WBCanSat/CanSatCode/FDR/FDR.pdf

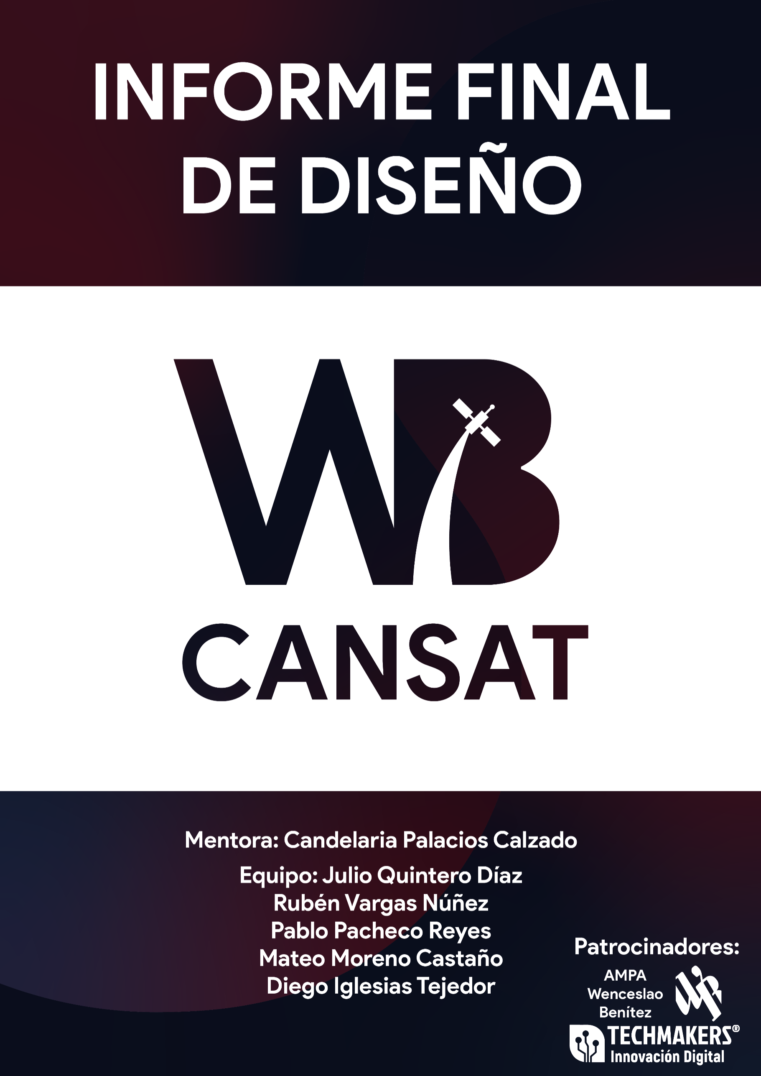
[picture p21: page 1]

## ÍNDICE

1.2. El equipo, el reparto de tareas y la organización del trabajo....... 3
3. DISEÑO MECÁNICO DEL CANSAT Y DE LA ESTACIÓN DE TIERRA...... 5

### 5. PROGRAMACIÓN. LENGUAJE DE PROGRAMACIÓN Y DIAGRAMA DE

FLUJO DEL PROGRAMA. BREVE EXPLICACIÓN DEL FUNCIONAMIENTO ... 10

7. SISTEMAS DE ATERRIZAJE. PARACAÍDAS U OTROS SISTEMAS.

### 10. PROYECTO CIENTÍFICO. DESCRIPCIÓN DEL PLAN DE ACTUACIÓN

DEL DÍA DEL LANZAMIENTO. PLANTEAR SOLUCIONES ANTE POSIBLES

11. ESTADO DE LA DIFUSIÓN Y DIVULGACIÓN DEL PROYECTO. FOTOS,

### 1. INTRODUCCIÓN/ ANTECEDENTES

### 1.1. Introducción

Este año, cursando 1º de bachillerato, nos embarcamos en el concurso CanSat, un proyecto a gran escala con el fin de desafiar nuestro conocimiento.

### 1.2. El equipo, el reparto de tareas y la organización del trabajo

- El equipo se conforma de cinco miembros: Julio Quintero, Pablo Pacheco, Mateo Moreno, Rubén Vargas y Diego Iglesias.
- Las tareas fueron asignadas teniendo en cuenta los conocimientos y capacidades de cada integrante, para lograr la máxima eficiencia.
- Debido a la pandemia hemos decidido organizarnos para que pudiéramos realizar todo desde nuestras casas:

❏ Hemos creado un grupo de Telegram y un sevidor de Discord para mantener contacto con nuestra mentora y realizar reuniones.

❏ Para la elaboración del informe CDR y FDR, trabajamos en Google Docs.

❏ Por último, hemos creado un WBS para organizar los trabajos que tenía que desarrollar cada uno

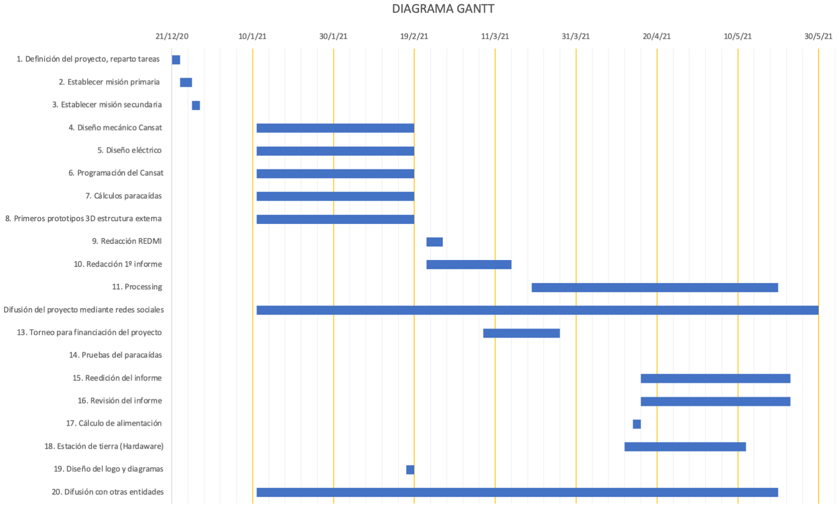
[picture p22: figure]

### 2. PROYECTO CANSAT

CanSat es un concurso diseñado para simular algunos de los objetivos principales de un satélite real, pero teniendo en cuenta una limitación importante: el tamaño de una lata. Es decir, hay que incluir los sensores, la alimentación y la comunicación necesaria en el espacio reducido de una lata.

### 2.1. Misiones

A continuación, se desarrollará las dos misiones principales en las que se basa el proyecto:

### 2.1.1. Misión primaria

Su objetivo es medir dos parámetros durante el descenso del CanSat, que serán la presión y la temperatura. La información captada se transmite a la estación de tierra a través de telemetría durante el transcurso de la bajada.

Hemos elegido la placa Arduino Nano como principal componente de hardware, como lenguaje de programación Arduino (C/C++) y como entorno de desarrollo Visual Studio Code.

### 2.1.2. Misión secundaria

En un principio, la idea era examinar la vegetación de la zona desde el satélite. Para ello, mediríamos la eficiencia de la fotosíntesis de las plantas, basándonos en la fluorescencia de la clorofila que éstas emiten, con ello podríamos determinar la salud de las zonas verdes, bosques, reservas naturales... Sin embargo, tras una exhaustiva investigación sobre este estudio, rechazamos la idea debido a la complejidad para encontrar sensores que se adaptaran al presupuesto máximo impuesto en las bases del concurso.

Así pues, aunque optamos por utilizar sensores MQ, el objetivo seguiría estando centrado en el medioambiente: identificar el aumento de emisiones de gases de efecto invernadero en vertederos, industrias, ciudades concurridas y otro tipo de zonas peligrosas que perjudiquen el medio ambiente y que estén por encima de las adoptadas en el Acuerdo de París. Todo ello para poder reducirlas cuando sean detectadas. Como se graficarán y representarán los datos se ampliará en el epígrafe 6.

Esta idea puede extrapolarse de distintas formas. Primeramente, aunque usemos sensores MQ que tienen baja resolución, se podrían utilizar espectrómetros de imagen de alta resolución (high-resolution imaging spectrometer) para poder observar estas variaciones desde la órbita terrestre. Un ejemplo a esto sería el satélite Iris de GHGSat, que puede observar altas concentraciones de metano.

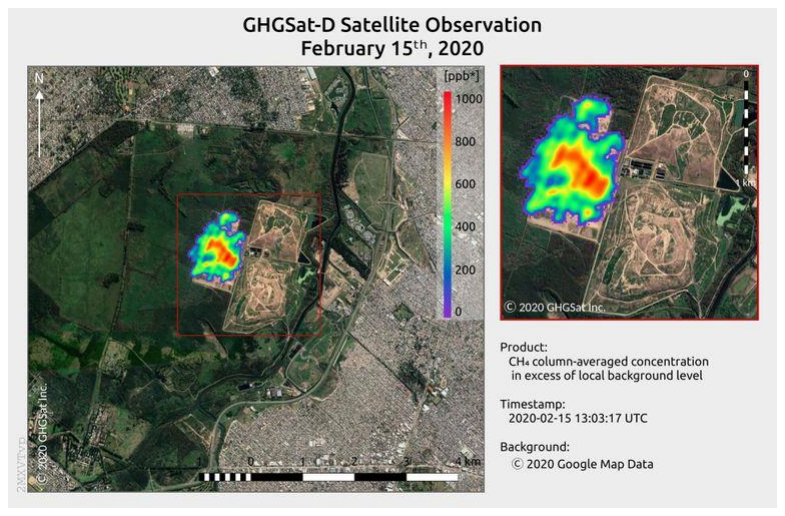
[picture p23: figure]
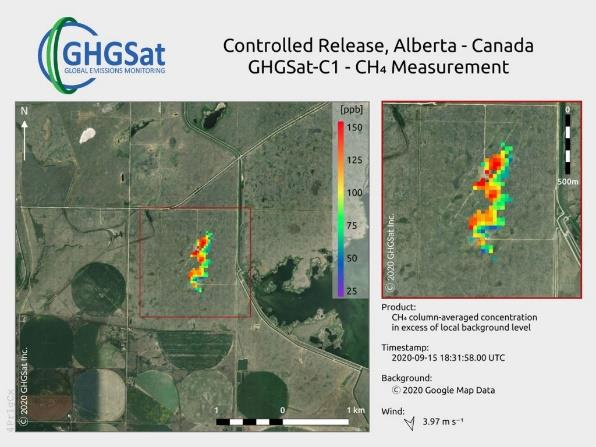
[picture p24: figure]

(Anon., 2021) | (Bishton, 2020)

A su vez, se pueden utilizar sensores que midan la concentración de la fluorescencia de la clorofila, en vez de aquellos que miden gases de efecto invernadero. Esta extrapolación estaría conectada con nuestra primera idea.

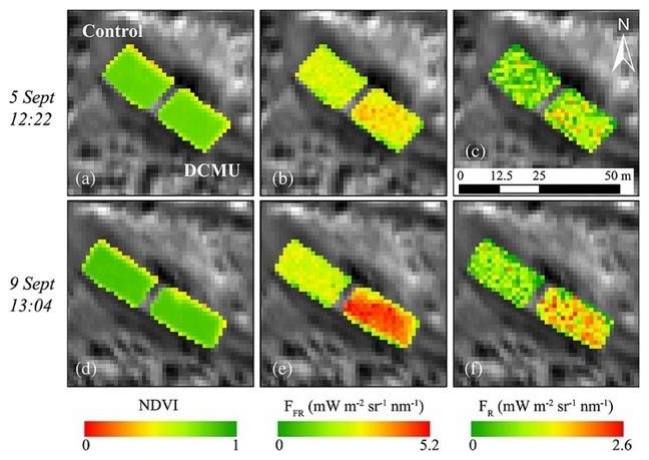
[picture p25: figure]

(Anon., 2015)

Por último, suponiendo que el Cansat fuese un satélite espacial, se podría utilizar para investigar las atmósferas de otros planetas y comprobar la presencia de gases que propicien la vida, tanto extraterrestre como para posibles colonias humanas.

### 2.2. Resultados esperados

Con nuestra misión esperamos obtener durante el descenso los valores de concentración de CH4 (metano) y CO2 (dióxido de carbono) cada segundo enviando los datos por telemetría a la estación de tierra. Con los datos obtenidos seremos capaces de determinar los niveles de concentración para cada uno de ellos y comprobar que valores no cumplen con los límites establecidos. Además de observar la relación que pueden tener estos parámetros con la temperatura de la zona específica.

### 3. DISEÑO MECÁNICO DEL CANSAT Y DE LA ESTACIÓN DE

TIERRA.

Al empezar a diseñar el CanSat nos dimos cuenta que tenía que tener unas medidas específicas, nuestro satélite no podía superar una altura de 115mm y 65mm de diámetro. Esto nos dio un poco de dificultad, pero con trabajo pudimos encajar todo. Aprovechamos que nuestro instituto disponía de una impresora 3D, para construir el diseño mediante diversas aplicaciones, hasta acabar con el resultado más profesional posible. Hemos decidido que nuestra estructura interna y externa están separadas, debido a que a la hora de manipularlos y trabajar con ellos va ser mucho más fácil que trabajar en un recipiente hermético de paredes.

### 3.1. Estructura Externa

Para la estructura externa, nos apoyamos principalmente en dos programas: Tinkercard y Freecad. En el primero, se esbozó el prototipo y en el segundo se utilizó para dar un acabado más profesional a la maqueta final.

Al principio pensamos en un prototipo que encajase mediante deslizamiento hacia arriba, pero lo descartamos, ya que podía ocasionar problemas con los cables Después, ideamos uno con bisagras, pero finalmente se descartó debido a la dificultad para incluir las bisagras en la carcasa de plástico.
Los dos últimos fueron los mejores, debido a que iban fijados con tornillos y era mucho más fácil a la hora de manipularlos. Tardamos unas 5 semanas, puesto que realizamos pruebas para ver su resistencia.
Tras ellas, decidimos poner las paredes laterales de 2 mm y las inferiores de 3mm en las bases, para lograr la resistencia adecuada para que no se rompiese.

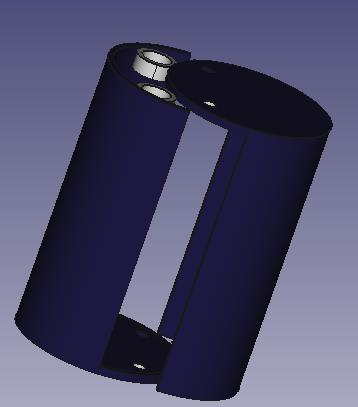
[picture p26: figure]
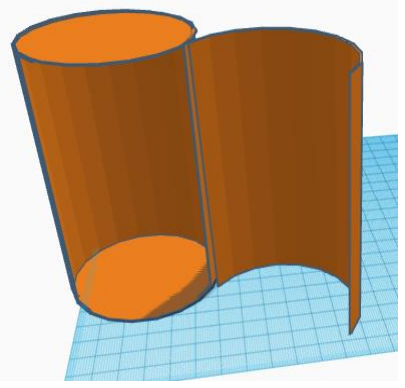
[picture p27: figure]
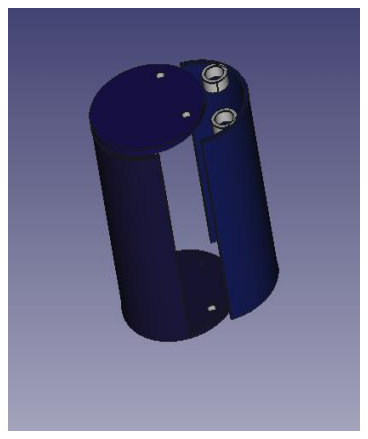
[picture p28: figure]

Para la impresión en 3D hemos probado con dos tipos de filamento, PLA y ABS, de 1.75 mm con el software CURA. Hemos tenido dificultades para imprimir ya que la impresora 3D del centro no soportaba bien la alta temperatura del ABS. Sin embargo, hemos conseguido imprimir un prototipo en PLA gracias a Manuel y su impresora.

Prototipo 1(TINKERCAD) | Prototipo 2(freecad) | Prototipo 3(freecad)

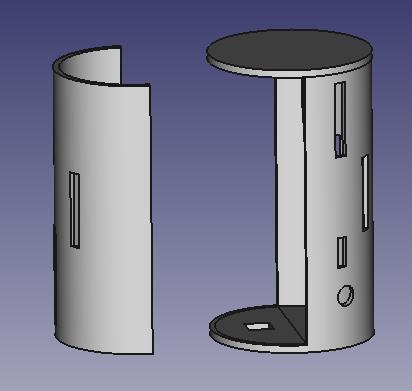
[picture p29: figure]

Cuenta | con | cuatro

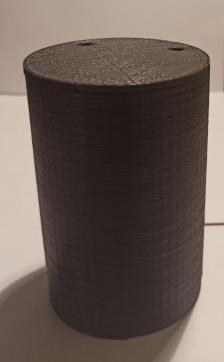
[picture p30: figure]
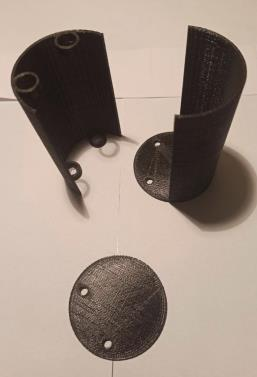
[picture p31: figure]

orificios de ventilación para que los sensores tomen la muestra de gases de la atmosfera. En ellos, también se insertan el led, el interruptor y sensor gps.

### 3.2. Estructura interna

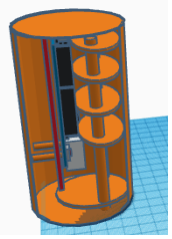
[picture p32: figure]

La condición principal es que fuera fácil de manipular y de este modo, si existiese algún problema con un sensor no sería necesario desconectar todos los cables.

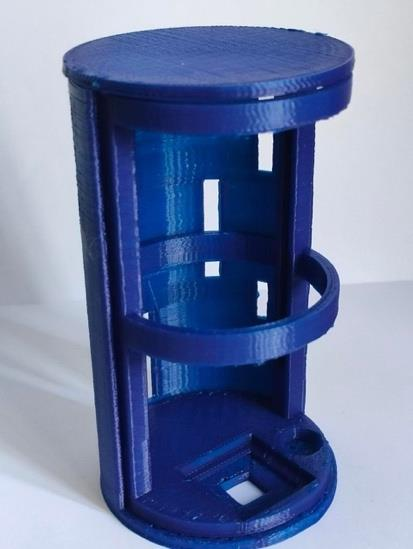
[picture p33: figure]
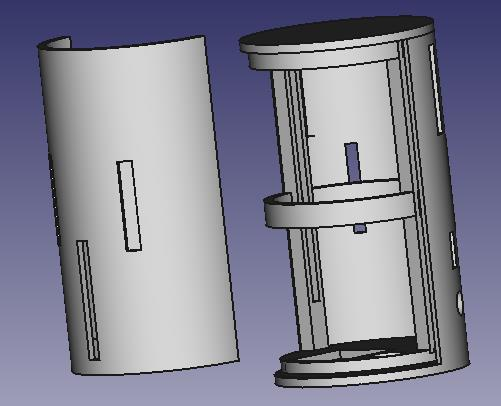
[picture p34: figure]

Al pasarlo al freecad retocamos un poco la idea del tinkercad, debido a que lo queríamos hacer una estructura un poco mas profesional y mas fácil de manipular.

### 3.3. Componentes

Prototipo 3 impreso

Prototipo final

Estructura interna final

Nombre | Masa | Dimensiones | Voltaje | Amperaje | Sensibilidad
BMP280 | 1.07g | 1.9x1cm | 4V | 20mA | Presión: +-1Hpa Temperatura: +-0.5ºC
MQ-4 | 6.8g | 3.2x2cm | 3.5V-5V | 150mA
GPS-NEO6 | 16.8g | 3.5x2.5 cm | 2.7V-3.6V | 37mA | +-2.5m en velocidad 0.1m/s
Zumbador | 1.2g | 3cm r | 3.5V-5.5V | 25mA | +-500Hz
MQ-135 | 6.8g | 3.2x2cm | 4V | 150mA

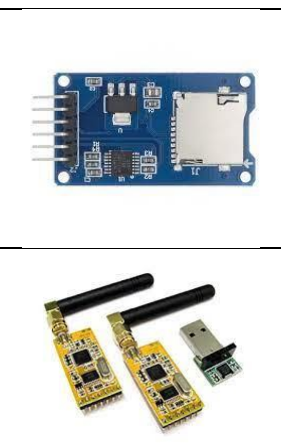
[picture p35: figure]

Lector Sd | 4.38g | 4.2x2.3cm | 3.3V-5V | 15 mA | X
Radio apc 220 | 11.4g | 3.7x1.8cm | 3.5V-5V | 30mA | X
Arduino nano | 5.89g | 4.3x1,7cm | 5V | 20mA | X
Masa componentes | 54,34 g
Masa componentes + pila | 101,27 g
Masa total (componentes, carcasa, paracaídas…) | 173,45 g

### 4. DISEÑO ELÉCTRICO

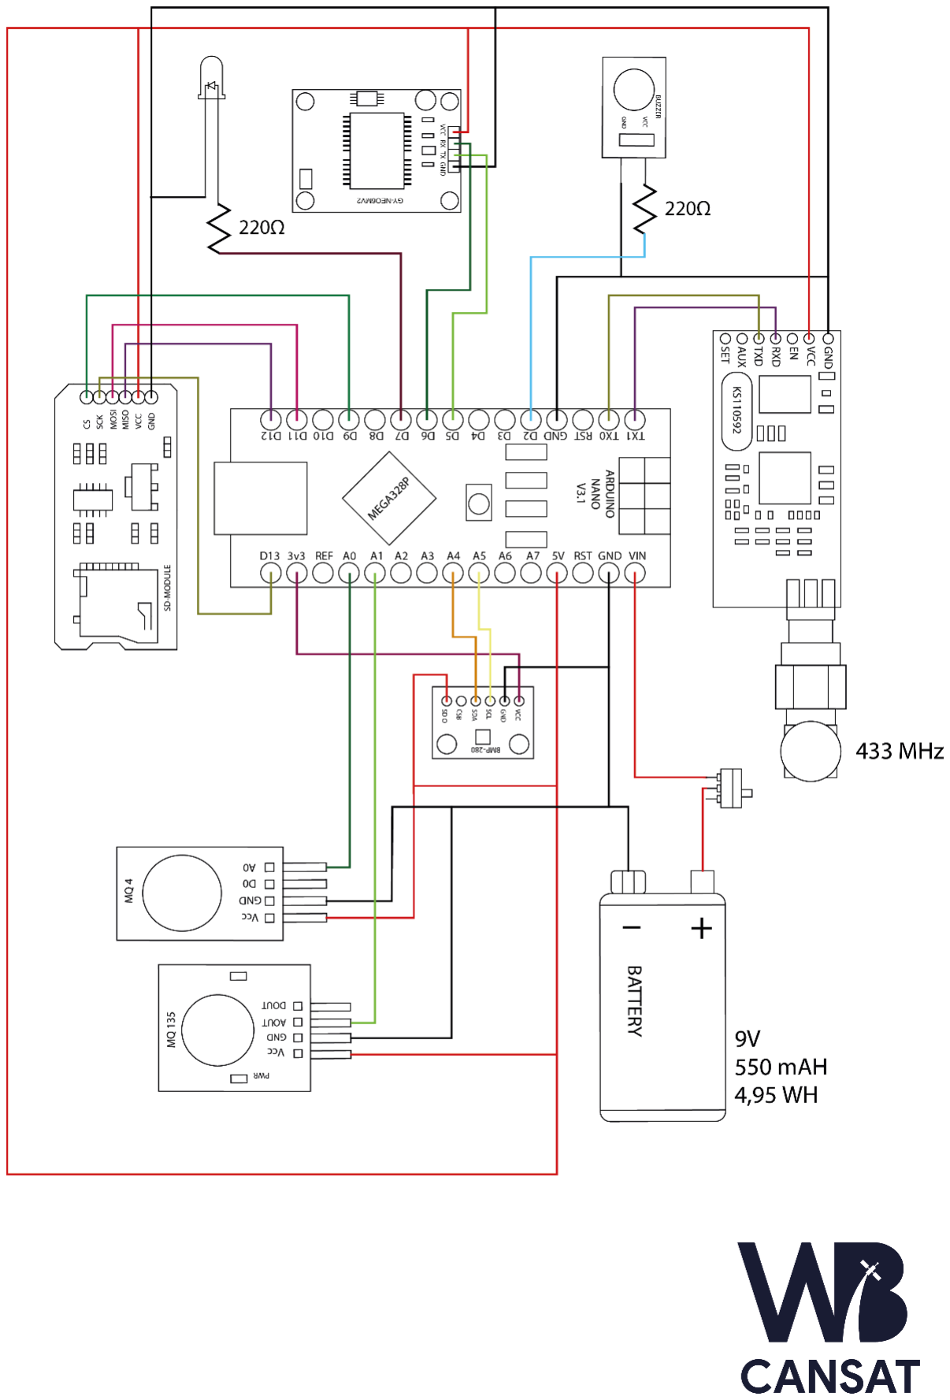
[picture p36: figure]

### 4.1. Componentes eléctricos

Hemos utilizado la placa Arduino Nano para conectar los componentes que se encuentran ilustrados en el diagrama superior debido al bajo costo, su menor dimensión y peso respecto a otros modelos, la facilidad para encontrar documentación y soporte y la amplia variedad de dispositivos con los que se puede conectar.

### 4.2. Placas PCB CanSat y Estación de Tierra

○Sistema de alimentación del CanSat

Utilizando un polímetro obtuvimos los siguientes datos de nuestro CanSat:

Voltaje Medio | Amperaje Medio | Potencia Media
6,41 V | 0,26 A | 1,67 W

Por lo que, hemos utilizado una pila 9 V, cuya autonomía es de:

Hautonomía =

Wpila
Wconsumido =

4,95 WH
1,67 W

= 2,96 ℎoras

Tiempo suficiente para hacer pruebas antes del lanzamiento y para este mismo. Teniendo un coste reducido y siendo fáciles de encontrar.

○Sistema de Transmisión y recepción de datos elegido

Para establecer la comunicación entre el CanSat y la estación de tierra hemos elegido el módulo apc220, debido a su bajo costo. La antena utilizada es una antena omnidireccional funcionando a una frecuencia de 433 MHz.

5. PROGRAMACIÓN. | LENGUAJE | DE | PROGRAMACIÓN | Y
DIAGRAMA DE FLUJO DEL PROGRAMA. BREVE EXPLICACIÓN DEL FUNCIONAMIENTO

El lenguaje de programación que hemos utilizado para nuestro proyecto es el propio lenguaje de Arduino (C y C++). Sin embargo, el entorno de desarrollo ha sido Visual Studio Code junto con las extensiones para Arduino y C/C.
A su vez, para la estación de tierra hemos usado Processing, un lenguaje de programación de código abierto basado en java. El entorno para este programa seguirá siendo Visual Studio Code.

### 5.1. Diagrama de flujo

En la siguiente página se expondrá el diagrama de flujo y se explicará detenidamente.

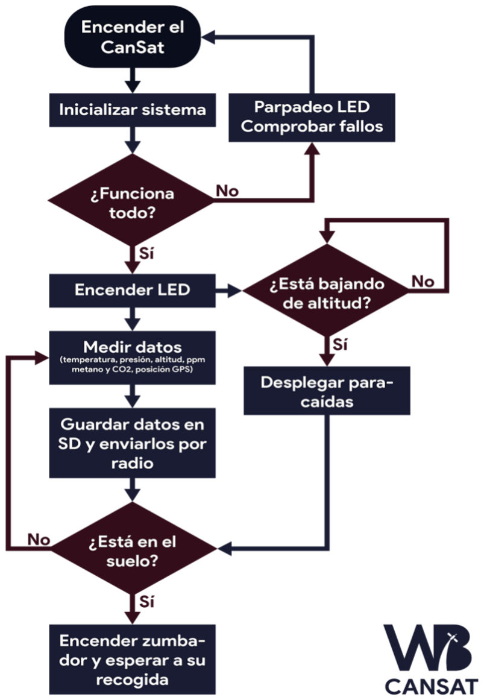
[picture p37: figure]

El código para saber si está bajando de altitud o si está en el suelo sería este:

if (!reach_ground){

//Read sensors and save data
}

if (altitude_val – pre_altitude_val > 3 && !top_alt && altitude_val > 200){

top_alt = true
//Deploy parachute and save maximum altitude
}

else if (pre_altitude == altitude && top_alt){ reach_ground = true
//Turn on the buzzer
}

Aunque el código al completo se mostrará a continuación, este fragmento puede servir de ayuda para entender el diagrama en mayor profundidad.

### 5.2. Programación

Una vez expuesto el diagrama de flujo vamos a mostrar el código que hemos programado. Antes de empezar decir que el código al completo se puede ver en nuestro GitHub (https://github.com/WBCanSat/CanSatProject), donde, además, se pueden encontrar más documentos e información sobre el proyecto; sin embargo, aquí explicaremos prácticamente la totalidad de este para que sea posible su comprensión.
Dicho esto, comenzaremos con la programación que estará presente en el CanSat.

### 5.3. CanSat

### 5.3.1. Misión primaria

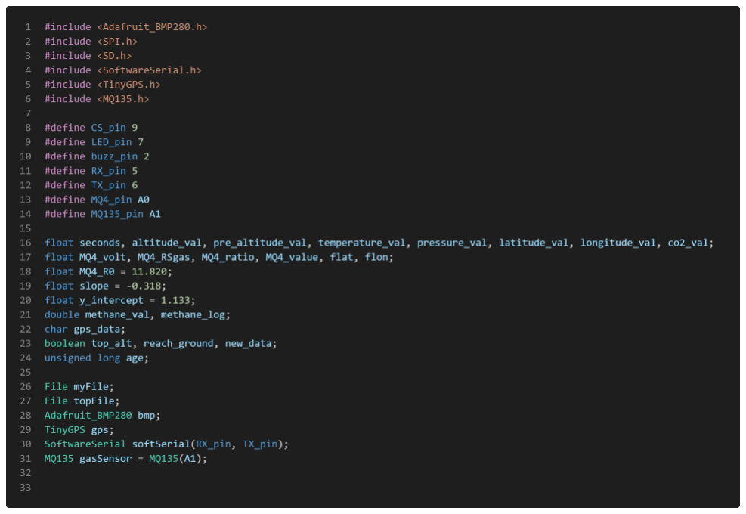
[picture p38: figure]

Primeramente, incluimos todas las librerías utilizadas para administrar las conexiones I2C y SPI. Además, se definen los pines y ciertas variables.

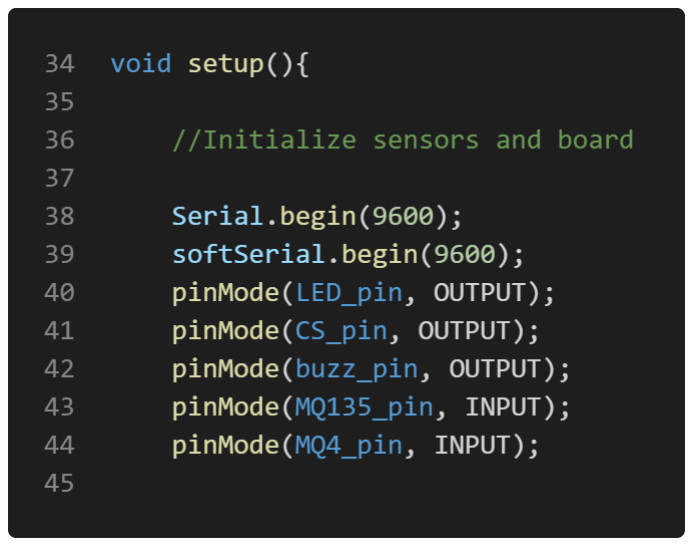
[picture p39: figure]
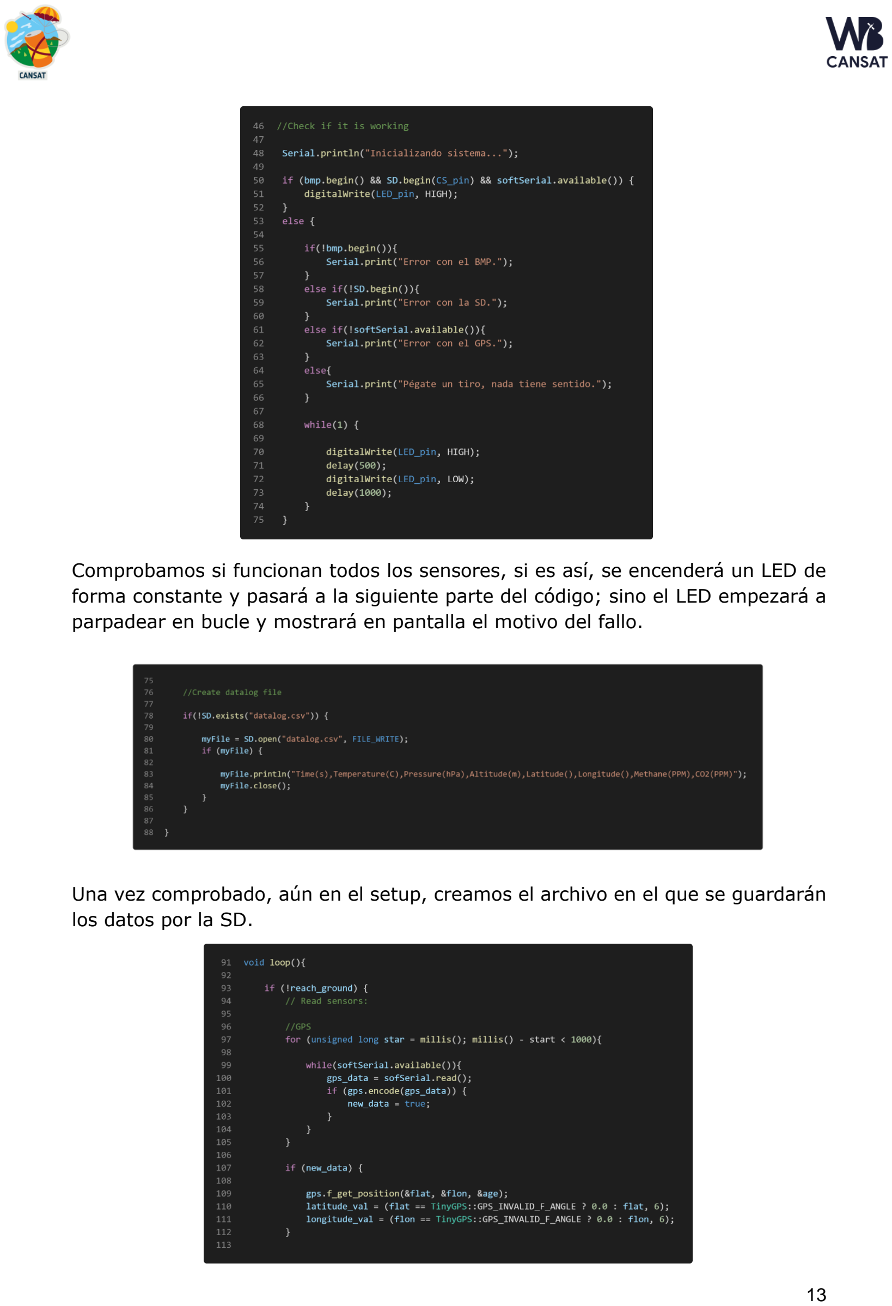
[picture p40: page 14]

Comprobamos si funcionan todos los sensores, si es así, se encenderá un LED de forma constante y pasará a la siguiente parte del código; sino el LED empezará a parpadear en bucle y mostrará en pantalla el motivo del fallo.

Una vez comprobado, aún en el setup, creamos el archivo en el que se guardarán los datos por la SD.

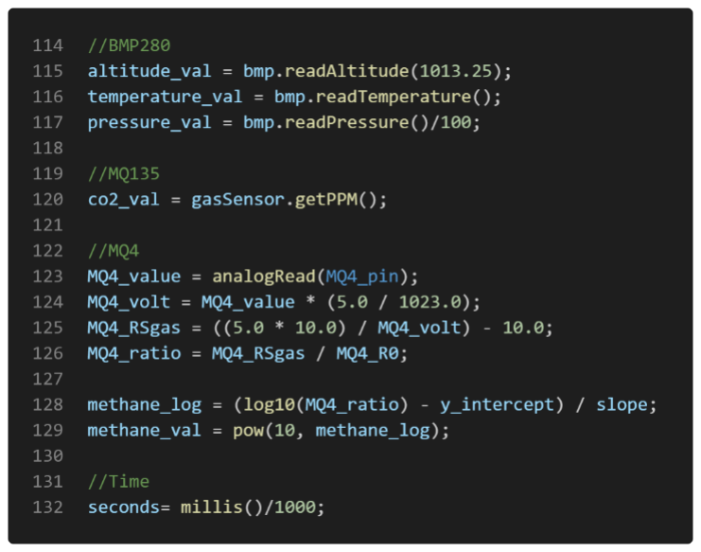
[picture p41: figure]

Ahora sí, comenzaríamos con el loop (la parte del código que se repetirá constantemente), primeramente, comprobamos si ha llegado al suelo, puesto que cuando llegue queremos que deje de enviar datos (la comprobación se verá más adelante); y si no lo ha hecho leerá los sensores.

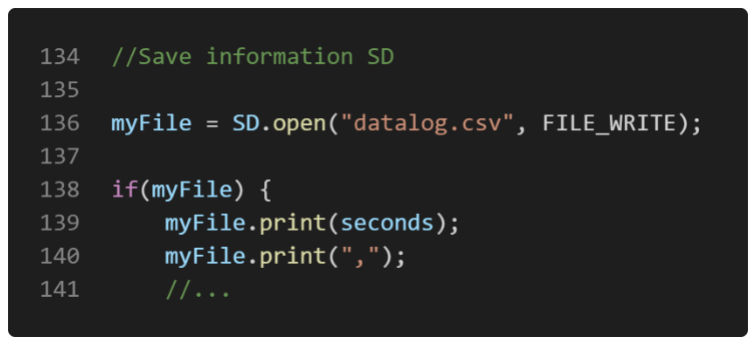
[picture p42: figure]

Una vez ha recogido los datos, los guardará en la SD y los enviará por radio.

Después de ello, comprobará si ha llegado a la altitud máxima, si es así creará un nuevo archivo en el que escribirá la altitud máxima y definirá la variable booleana top_alt como cierta (esta se refiere a si ha llegado a la altura máxima).

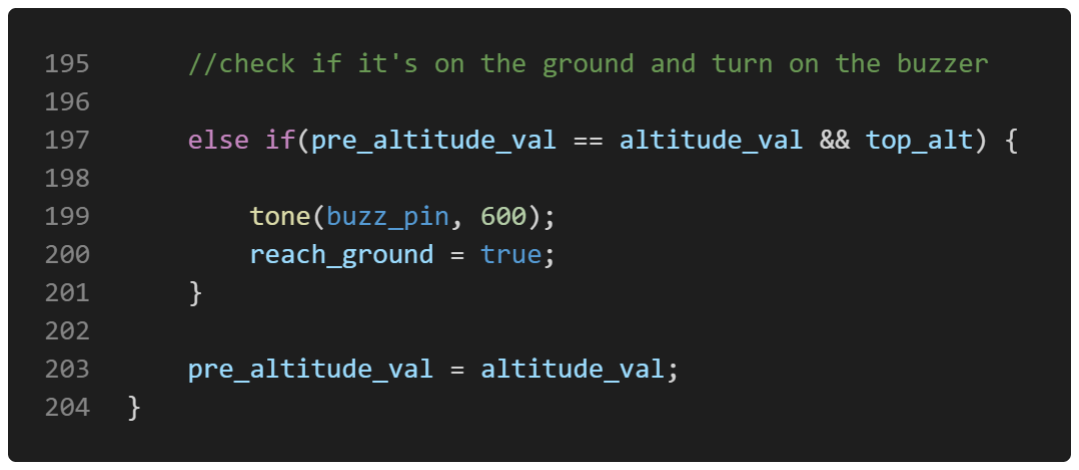
[picture p43: figure]

Finalmente comprobará si ha llegado al suelo, y si es así encenderá el zumbador para facilitar la búsqueda del lugar de caída del CanSat y establecerá la variable booleana reach_ground como verdadera para que no envíe más datos, ni los escriba en la SD. Por último, establecerá el valor de la altitud de ese ciclo como el anterior y volverá a empezar de nuevo el bucle (loop).

### 5.3.2. Misión secundaria

La misión secundaria todavía no está programada, seguimos en su desarrollo; sin embargo, será simplemente añadir las librerías necesarias para cada sensor y medir sus variables; además de enviarlos por radiofrecuencia y escribirlos en la SD. El cuerpo del programa se mantendrá como se ha visto anteriormente.

### 5.4. Estación de tierra

Para la estación de tierra, se programó una interfaz en processing la cual al recibir del puerto serial los valores procedentes de los sensores aportados por el código de Arduino reproduce cinco funciones con cada uno de los sensores con sus valores correspondientes. Con este programa se pueden visualizar en la estación de tierra en tiempo real los datos registrados por los sensores durante la caída recibidos gracias a la antena. El código esta subido en GitHub y se puede visualizar en el subsiguiente enlace:
https://github.com/WBCanSat/CanSatProject/tree/main/CanSatCode/Ground%2 0Station (https://github.com/WBCanSat/CanSatProject/tree/main/CanSatCode/Ground%20Station)

### 6. SISTEMAS IMPLICADOS EN LA ESTACIÓN DE TIERRA

### 6.1. Explicación

La estación de tierra es la encargada de recibir y procesar los datos enviados por el CanSat durante su misión. Los datos que recibirá serán los recogidos por los sensores (presión, altitud, temperatura, posición GPS, ppm CO2, ppm metano...). Estos datos se tratarán y graficarán en tiempo real, la intención es tener una gráfica con cada dato por separado y, además, utilizar la posición GPS para poner un plano en el que se mapearán los datos, según la posición en la que sean recogidos. A continuación, se muestra un ejemplo de lo que queremos conseguir de mapeo (los datos son aleatorios y no representan los valores que esperamos obtener):

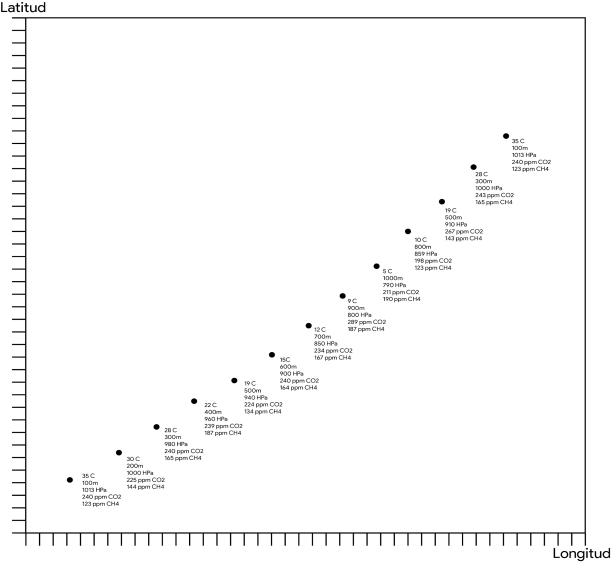
[picture p44: figure]

También nos gustaría resaltar con colores los datos obtenidos, para que se vean más fácilmente y para simular, como se verían si se usasen sensores de espectrometría de imagen de alta resolución. Se muestra un ejemplo de lo que queremos conseguir y una imagen captada con un espectrómetro aéreo de imagen de alta resolución

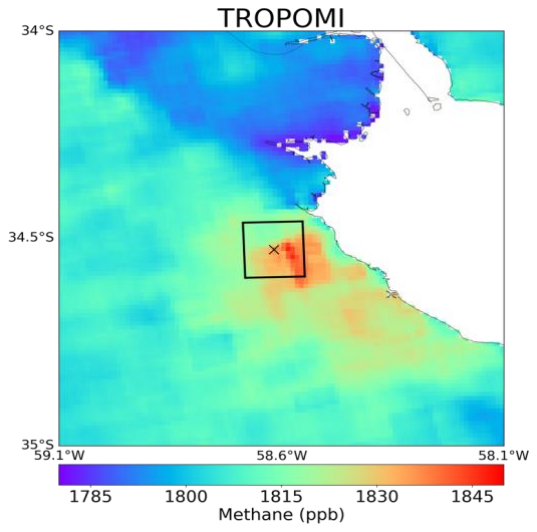
[picture p45: figure]

(León, 2020)

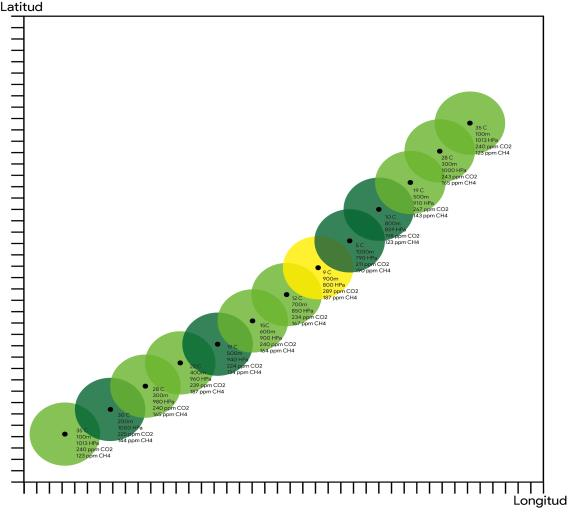
[picture p46: figure]

### 6.2. Componentes

Los componentes utilizados para la recepción de la señal enviada por el CanSat serán:
1. Módulo de radio: APC220. Será el encargado de recibir la señal enviada por el otro módulo APC220 abordo del CanSat. La antena utilizada es una antena omnidireccional tipo duck. La señal se enviará en una frecuencia que oscilará entre los 433 y los 435 MHz
2. Portátil: tendrá conectado el módulo de radio y cargado el programa desarrollado con Processing, donde se procesarán, graficará y mapearán los datos recibidos.

7. SISTEMAS DE ATERRIZAJE. PARACAÍDAS U OTROS SISTEMAS. PLANTEAMIENTO DE LA IDEA.

Queremos que cuando empiece el descenso desde los aproximadamente 1000 metros se despliegue el paracaídas y queremos que el tiempo de vuelo máximo sea de 120 segundos. Queremos que el paracaídas tenga una forma de cruz para conseguir que el CanSat baje a una velocidad entre 8-11 m/s. El paracaídas se almacenará desde un principio encima del CANSAT y si hay algún inconveniente se pondrá en el lugar más adecuado.

### 7.1. Diseño

Según la organización, la altitud a la que llegará el CanSat será de unos 1000 metros aproximadamente y su tiempo de vuelo máximo no puede superar los 120 segundos, por lo que queremos que el CanSat baje a una velocidad de entre 8-11 m/s. Para ello, hemos diseñado un paracaídas de tipo cruz que se encuentra en la parte superior del CanSat y que se desplegará cuando comience el descenso.

### 7.2. Cálculos

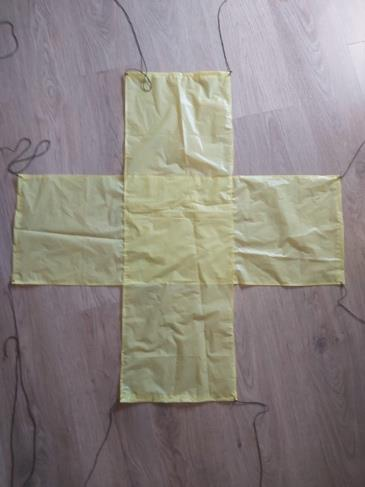
[picture p47: figure]

Para realizar los cálculos para averiguar el área necesaria para el paracaídas utilizamos esta fórmula para durante el descenso:

A =

2 ⋅ m ⋅ g
C ⋅ p ⋅ v

2

- | m= | masa máxima del CanSat = 350g
- g = gravedad = 9.8 m/s²
- A = superficie del paracaídas (en nuestro caso de cruz).
- v = velocidad de descenso = 8-11 m/s (se realizan dos cálculos, uno
| para el área más pequeña con 8 m/s y otro para el área más grande
| con 11 m/s
- C = coeficiente rozamiento = 0.8
- P = coeficiente rozamiento del aire = 1.225 kg/m3

A =

2 ⋅ 0,350 ⋅ 9,8
0,8 ⋅ 1,225 ⋅ 8

2 = 0,636

A =

2 ⋅ 0,350 ⋅ 9,8
0,8 ⋅ 1,225 ⋅ 11² = 0,875
- Resultado área más pequeña: 0,636 m²
- Resultado área más grande: 0,875 m²

Los videos realizando las pruebas se pueden ver en el GitHub. Se adjunta, a continuación, el enlace:

https://github.com/WBCanSat/CanSatProject/tree/main/FDR/Videos

De ellas extraemos la conclusión de que el cansat tendrá un aterrizaje seguro.

Peso (g) | Tiempo (s) | Velocidad media (m/s)
100 | 4,28 | 2,803738318
200 | 3,54 | 3,389830508
300 | 2,96 | 4,054054054
400 | 2,78 | 4,316546763
500 | 2,62 | 4,580152672
Altura (m) | 12
- Resultado área más pequeña: 0.3181 m²
- Resultado área más grande: 0.4375 m²

### 7.3. Material

Para la fabricación del paracaídas hemos utilizado bolsas hechas de nylon, un material resistente y ligero ideal para paracaídas. Para conectar los extremos y coser el paracaídas hemos utilizada tanza.

### 8. PRESUPUESTO DETALLADO. DIFERENCIAS CON EL INICIAL

Al principio del proyecto no sabíamos con seguridad cómo sería el precio final tras obtener todos los sensores y el equipamiento necesario, asumimos que íbamos a gastar menos de 200€ en total en el proyecto. Tras hacer mucha búsqueda y hacer un recuento de los precios de cada producto, hemos reducido el precio final a 111.53€ que es más barato que lo que en un principio asumimos. Estas diferencias se deben a que hicimos esta suposición al principio del proyecto, solo teniendo en cuenta que el presupuesto máximo era de 500€ y que no teníamos aún información sobre los sensores que acabaríamos utilizando.

### 8.1. Lista Presupuesto

Aquí está la lista de los sensores y otros materiales con sus respectivos precios:

Material | Imagen Material | Cantidad | Precio unitario | Precio total
MQ-135 | | 1 | 2.95€ | 2.95€
MQ-4(Sensor metano) | | 1 | 2.53€ | 2.53€
GY-NEO6MV2 NEO-6M 3V-5V (GPS) | | 1 | 9.99€ | 9.99€
BMP280 (Presión y temperatura) | | 1 | 4.59€ | 4.59€
2 lectores Micro-SD Arduino | | 1 | 6.99€ | 6.99€
4022 6F22 6LR61 (pila 9V) | | 1 | 1.69€ | 1.69€
Tela paracaídas | | 1 | Chubasquero de Naylon:2€ | 3.50
Cordajes (Tanza) | | 1 | 2€ | 2€
Zumbador Pasivo 5V | | 2 | 0.59€ | 1.19€

Conector/Adaptador para pila 9V 6LF22 | 1 | 0.99€ | 0.99€
Kit Arduino compatible UNO Mini Básico | 1 | 16.36€ | 16.36€
Rollo de filamento ICEFIL1ABS085 | 1 | 16.94€ | 16.94€
Kit de soldadura | 1 | 11.88€ | 11.88€
Interruptor 2P2T-50V-05A | 1 | 0.49€ | 0.49€
Radio apc 220 | 1 | 17.44€ | 17.44€
Arduino Nano | 1 | 12.00€ | 12.00€
| | Total: | 111.53€

### 9. FINANCIACIÓN Y APOYO TÉCNICO

### 9.1. Financiación

Para la financiación hemos optado seguir dos estrategias distintas de forma simultánea:
1. Patrocinio de una empresa local llamada TechMakers (cuya página web es: https://techmakers.es). Contactamos con ella, le explicamos el proyecto y nos facilitó varios sensores y componentes (Lector SD, GPS, módulo de radio y sus impresoras 3D para imprimir la carcasa de nuestro CanSat); por lo que estamos eternamente agradecidos por su colaboración.
2. Financiación a través de un torneo de videojuegos online que celebrado entre el 26 y 27 de marzo para obtener beneficios cubriendo, de este modo los gastos que suponen la creación del CanSat. Para ello, contactamos con nuestro centro el cual aportó 90€ junto con el AMPA (45 euros el centro y 45 euros el AMPA) para facilitar los premios del torneo. No conseguimos contactar con ninguna empresa que quisiera facilitarnos algún producto para los premios. Sin embargo, con el dinero aportado por las dos instituciones anteriores fue suficiente para atraer a jóvenes al torneo. Una vez finalizado, el concurso extrajimos 90 euros de beneficios. A continuación, se muestra los carteles que creamos para promocionar el torneo mediante las redes sociales.

### 9.2. Apoyo técnico

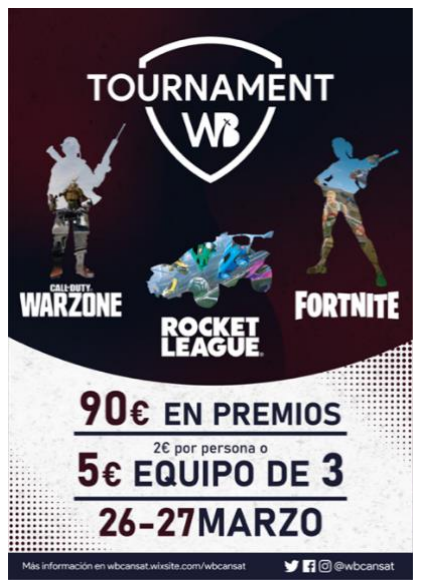
[picture p48: figure]

Para la creación del CanSat hemos contado y contamos con varias personas que nos están apoyando:
- Manuel Trigueros, profesor del IES Wenceslao Benítez, que nos está ayudando con las dudas que tenemos relacionadas con la electrónica y la programación.
- María del Mar Díaz, familiar, que ha accedido a coser el paracaídas, pues tiene bastante experiencia en la costura y hará un mejor trabajo que nosotros (aunque los gores están ya diseñados, el paracaídas todavía no está hecho).
- Candelaria Palacios, nuestra mentora, que nos ayudó a contactar con TechMakers, a organizarnos, a buscar ideas, a redactar este informe y a un sinfín de cosas más.

### 10. PROYECTO CIENTÍFICO. DESCRIPCIÓN DEL PLAN DE

ACTUACIÓN | DEL | DÍA | DEL | LANZAMIENTO. | PLANTEAR
SOLUCIONES ANTE POSIBLES IMPREVISTOS.

### 10.1. SOLUCIONES A POSIBLES PROBLEMAS

### 10.1.1. Funcionamiento del CanSat

Si se detecta algún tipo de error en nuestro Cansat, desmontaremos su estructura, solucionándolo cuanto antes. Esto podría implicar el reemplazo de algún sensor, de algún tornillo o la sustitución de cables. Para ello, estaremos previstos con material de sustitución, herramientas y cables y otras piezas. Además, revisaríamos los códigos de programación para encontrar el origen del problema.

### 10.1.2. Realización de la misión principal y secundaria

Ante cualquier problema con los sensores que imposibiliten el regular desarrollo de ambas misiones, revisaremos lo sensores, editaremos los códigos y si finalmente no funcionan se remplazarían por algunos de repuesto. Todos los sensores serán probados anteriormente al día del lanzamiento para asegurarnos su correcto funcionamiento.

### 10.1.3. Comunicación por radio

Cuando realizamos las pruebas comprobamos que la radio funciona correctamente, pero en el caso de que hubiera dejado de emitir señal localizaríamos el problema utilizando processing para comprobar la existencia de algún error. Estamos previstos con una radio de repuesto por si se hubiese dañado y fuera necesario sustituirla por una nueva.

### 10.1.4. Pruebas del paracaídas

Si existiese algún problema con el paracaídas, revisaríamos los cálculos, la tela o la tanza para cerciorarnos de un seguro aterrizaje. En el caso de que sucediese el día lanzamiento llevaríamos un paracaídas de repuesto igual al original desconectando, de este modo el paracaídas estropeado y atándolo al CanSat el nuevo.

11. | ESTADO | DE | LA | DIFUSIÓN | Y | DIVULGACIÓN | DEL
PROYECTO. FOTOS, VÍDEOS, ENLACES DEL PROGRESO.

Para llevar a cabo la divulgación del proyecto, nos hemos apoyado principalmente en el uso de las redes sociales. La información ha estado en continua retroalimentación aportando diariamente nuestro progreso y toda aquella documentación que creíamos necesaria que se conociese. Twitter, Instagram y Facebook han sido nuestras herramientas de comunicación con el público. También, hemos creado un GitHub registrando todo el progreso en cuanto a la programación y otros documentos, para cualquier persona que desee consultarlo. A continuación, se adjunta el enlace para poder acceder a nuestras redes sociales y sitios webs:

Red
social
Usuario | Enlace web

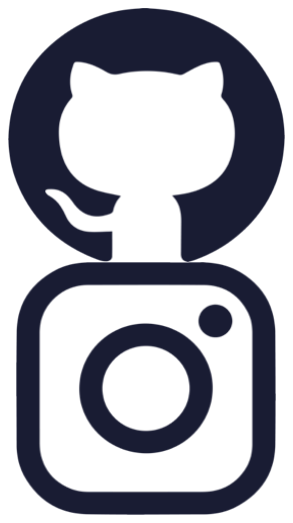
[picture p49: figure]

GitHub | Wbcansat | https://github.com/WBCanSat/CanSatProject

Instagra
m
wbcansat | https://www.instagram.com/wbcansat/ ?igshid=1b64ue1rplmxx

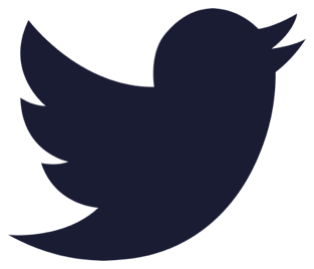
[picture p50: figure]

Twitter | WBCansat | https://twitter.com/wbcansat?s=21
Facebook WB Cansat | https://www.facebook.com/wb.cansat

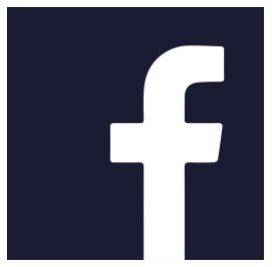
[picture p51: figure]

Hemos creado un logo personalizado para una mejor identificación del equipo. Se ha creado a partir de las iniciales “WB” de nuestro centro Wenceslao Benítez, que han sido modificadas para tener una apariencia más moderna, innovadora y conectada con el mundo de las tecnologías. En el interior de la “B” se observa un satélite despegando, que simboliza el propósito de nuestro proyecto, lanzar un satélite. El color principal es el Pantone 4146 C y el secundario el Pantone 4102C.

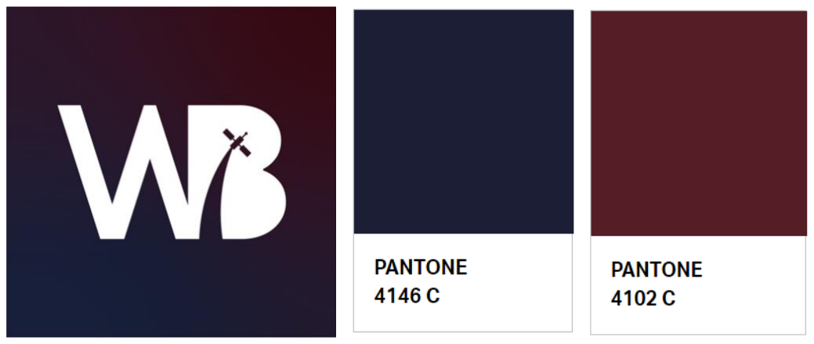
[picture p52: figure]

Por otro lado, estamos realizando una campaña de difusión en el instituto, a través de la cual presentaremos el proyecto a otros alumnos con el fin de motivar a los más jóvenes para que en un futuro se animen a participar en este tipo de concursos.

### 11.1. Difusión con el ayuntamiento

Para divulgar los conocimientos científicos y tecnológicos pensamos en recurrir a entidades que proporcionen una mejor visibilidad al proyecto, y que al mismo tiempo nos ayuden a acercarnos a un mayor número de usuarios. Aunque finalmente, no nos ha no ha sido posible conseguir difusión con el Ayuntamiento de San Fernando, se adjunta, a continuación, un enlace al documento que hace
referencia | a | la | propuesta | de | difusión | que | solicitamos:
https://github.com/WBCanSat/CanSatProject/blob/main/CDR/Townhall%20reque st.pdf (https://github.com/WBCanSat/CanSatProject/blob/main/CDR/Townhall%20request.pdf)

### 12. AGRADECIMIENTOS

Finalmente, queremos agradecer a TechMakers por aportar material a nuestro proyecto (Lector SD, GPS, módulo de radio y la posibilidad de imprimir en 3D la carcasa del CanSat). A Manuel Trigueros, profesor de nuestro centro IES Wenceslao Benítez, que nos ha ayudado con algunos de los problemas que hemos y estamos encontrando por el camino; además de ser nuestra principal fuente para resolver dudas relacionadas con la electrónica. A Diego Iglesias, alumno del centro que ha aceptado colaborar en la campaña de financiación para el proyecto y que nos está ayudando a organizar un torneo para recaudar fondos, gracias al cual podremos pagar ciertos sensores y componentes del proyecto. A Candelaria Palacios, nuestra mentora, a la cual le debemos esta increíble oportunidad que se nos ha ofrecido y que nos ha estado apoyando en todo lo que ha podido, tanto mental como económicamente. A María del Mar Díaz, familiar que nos va a ayudar en la costura del paracaídas, debido a su experiencia en este hábito. Al IES Wenceslao Benítez y al AMPA por financiar los premios para el torneo. Y, sobre todo, a todos aquellos que nos están siguiendo y apoyando en todo momento a través de las redes sociales.

### 12.1. BIBLIOGRAFÍA: REFERENCIAS E INFORMACIÓN UTILIZADA

- Anon., 2015. AGU. [En línea]
Available at: https://agupubs.onlinelibrary.wiley.com/doi/full/10.1002/2014GL062943

- Anon., 2019. Esero. [En línea]
Available at: http://esero.es/cansat/
- Anon., 2020. Luis Llams. [En línea]
Available at: https://www.luisllamas.es/medir-temperatura-y-presion-barometrica-conarduino-y-bmp280/
- Anon., 2021. Barnacle News. [En línea]
Available at: https://thebarnaclenews.com/ngc-signs-game-changing-mou-withorbital-eye-b-v-in-actioning-its-green-agenda/
- Anon., s.f. Shield o módulo GPS con Arduino: Introducción. [En línea] Available at: https://www.geekfactory.mx/tutoriales/tutoriales-arduino/shield-omodulo-gps-con-arduino/
- Bishton, D., 2020. Spatial Source. [En línea]
Available at: https://www.spatialsource.com.au/gis-data/microsatellite-recordssmallest-methane-leak-detected-from-space/attachment/sfl-ghgsat-image
- CanSat, E., 2019. Edición 2019. [En línea]
Available at: http://esero.es/cansat/ediciones-anteriores/cansat-edicion-2019/
- Cansat, E., 2020. Edición 2020. [En línea]
Available at: http://esero.es/cansat/ediciones-anteriores/cansat-edicion-2020/
- Esa, 17/09/2020. High-resolution methane emissions data for waste management. [En línea]
Available at:
https://www.esa.int/Applications/Observing_the_Earth/Copernicus/Sentinel-5P/High-resolution_methane_emissions_data_for_waste_management
- ESA, 2015. Plant power from above. [En línea]
Available at:
http://www.esa.int/Applications/Observing_the_Earth/Plant_power_from_above
- ESA, 2015. Plant power from above. [En línea]
Available at:
http://www.esa.int/Applications/Observing_the_Earth/Plant_power_from_above
- Kate Maxwell, G. N. J., 2000. Oxford Academy. [En línea]
Available at: https://academic.oup.com/jxb/article/51/345/659/652534
- León, F. M., 2020. Meteored. [En línea]
Available at: https://www.tiempo.com/ram/datos-de-emisiones-de-metano-de-altaresolucion.html
- Meteored, 18/09/2020. Datos de emisiones de metano de alta resolución. [En línea] Available at: https://www.tiempo.com/ram/datos-de-emisiones-de-metano-de-altaresolucion.html
- Meteored, 18/09/2020. Datos de emisiones de metano de alta resolución. [En línea] Available at: https://www.tiempo.com/ram/datos-de-emisiones-de-metano-de-altaresolucion.html
- W. W. Biggs, A. R. E. J. D. E. K. W. B. J. W. M. a. M. D. C., 1971. JSTOR. [En línea] Available at: https://www.jstor.org/stable/1934743?seq=1
