WBCanSat/CanSatCode/CanSatCode/Ground Station/background.jpg

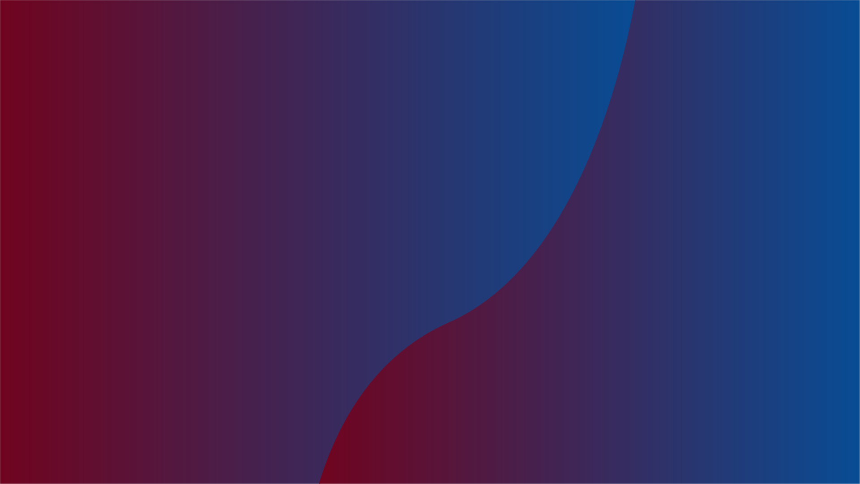
CanSatCode/Ground Station/background.jpg
