WBCanSat/CanSatCode/Tests/Transmission Test/Test_image.PNG

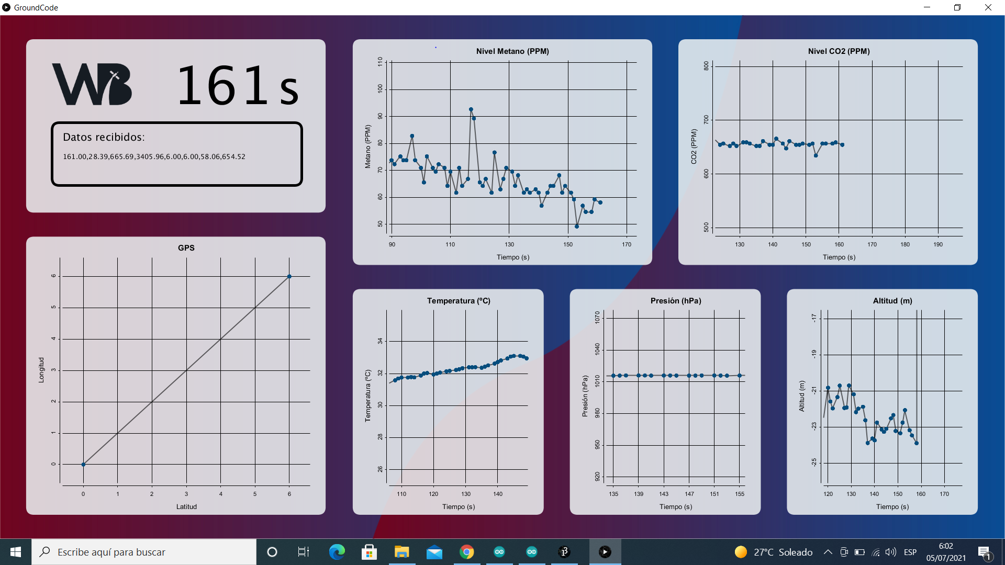
Tests/Transmission Test/Test_image.PNG
