WBCanSat/CanSatCode/(commit log)

2021-01-29 No sé que hago
2021-02-10 Parachute calcs added
    [Parachute calcs.xlsx]
2021-06-23 Ground Station Code updated
2021-06-26 Ground Station Code updated and finished: - Design updated - Save function added - Minor fixes
    [GroundCode.pde]
